KirillKobyakov/RP2350_Console/README.md

# RP2350_Console
A custom RP2350b console, which will include an LCD screen and rotary quad encoders. In this repository will include both hardware and software components for the design as well as assembly components and a tutorial.
