KirillKobyakov/RP2350_Console/Hardware/RP2350b_Console/RP2350_QFN80.step

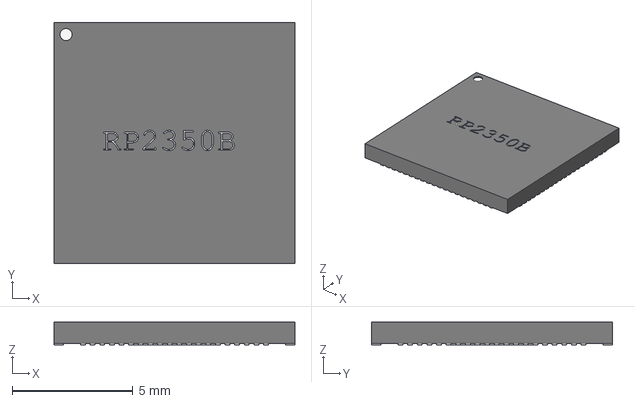
[picture p1: CAD file, 2025-08-28, an earlier design]
Hardware/RP2350b_Console/RP2350_QFN80.step
10.0 x 10.0 x 0.95 mm
