KirillKobyakov/RP2350_Console/Software/make.txt

arm-none-eabi-gcc -ffreestanding -march=armv8-m.main+fp+dsp -mfloat-abi=hard -mthumb -std=c11 -pedantic -Os  -Idrivers -Ibaremetal/include -Ilib -Iinclude -fdata-sections -ffunction-sections -Xlinker -gc-sections -Wall -c drivers/oled_spi.c -o oled_spi.o
arm-none-eabi-gcc -ffreestanding -march=armv8-m.main+fp+dsp -mfloat-abi=hard -mthumb -std=c11 -pedantic -Os  -Idrivers -Ibaremetal/include -Ilib -Iinclude -fdata-sections -ffunction-sections -Xlinker -gc-sections -Wall -c drivers/systick.c -o systick.o
arm-none-eabi-gcc -ffreestanding -march=armv8-m.main+fp+dsp -mfloat-abi=hard -mthumb -std=c11 -pedantic -Os  -Idrivers -Ibaremetal/include -Ilib -Iinclude -fdata-sections -ffunction-sections -Xlinker -gc-sections -Wall -c drivers/led.c -o led.o
arm-none-eabi-gcc -ffreestanding -march=armv8-m.main+fp+dsp -mfloat-abi=hard -mthumb -std=c11 -pedantic -Os  -Idrivers -Ibaremetal/include -Ilib -Iinclude -fdata-sections -ffunction-sections -Xlinker -gc-sections -Wall -c drivers/encoder.c -o encoder.o
arm-none-eabi-gcc -ffreestanding -march=armv8-m.main+fp+dsp -mfloat-abi=hard -mthumb -std=c11 -pedantic -Os  -Idrivers -Ibaremetal/include -Ilib -Iinclude -fdata-sections -ffunction-sections -Xlinker -gc-sections -Wall -c drivers/gpio_irq.c -o gpio_irq.o
arm-none-eabi-gcc -ffreestanding -march=armv8-m.main+fp+dsp -mfloat-abi=hard -mthumb -std=c11 -pedantic -Os  -Idrivers -Ibaremetal/include -Ilib -Iinclude -fdata-sections -ffunction-sections -Xlinker -gc-sections -Wall -c baremetal/_crt0.c -o _crt0.o
arm-none-eabi-gcc -ffreestanding -march=armv8-m.main+fp+dsp -mfloat-abi=hard -mthumb -std=c11 -pedantic -Os  -Idrivers -Ibaremetal/include -Ilib -Iinclude -fdata-sections -ffunction-sections -Xlinker -gc-sections -Wall -c baremetal/_flash_init.c -o _flash_init.o
arm-none-eabi-gcc -ffreestanding -march=armv8-m.main+fp+dsp -mfloat-abi=hard -mthumb -std=c11 -pedantic -Os  -Idrivers -Ibaremetal/include -Ilib -Iinclude -fdata-sections -ffunction-sections -Xlinker -gc-sections -Wall -c baremetal/_newlib_stubs.c -o _newlib_stubs.o
arm-none-eabi-gcc -ffreestanding -march=armv8-m.main+fp+dsp -mfloat-abi=hard -mthumb -std=c11 -pedantic -Os  -Idrivers -Ibaremetal/include -Ilib -Iinclude -fdata-sections -ffunction-sections -Xlinker -gc-sections -Wall -nostartfiles -specs=nano.specs -T baremetal/_flash.ld  -o dig_etch_a_sketch.elf src/dig_etch_a_sketch.c oled_spi.o systick.o led.o encoder.o gpio_irq.o _crt0.o _flash_init.o _newlib_stubs.o

Generated Program has the following segments: n

section  size  addr
.boot    296   0x10000000
TEXT     1908  0x10000128
DATA     2     0x20000000
BSS      1105  0x20000008
tools/elf2uf2.py -v dig_etch_a_sketch.elf
dig_etch_a_sketch.elf is valid 32b ARM little-endian ELF file
ELF contains loadable flash segment at 0x10000000
ELF contains loadable flash segment at 0x1000089c
Skipping program header for non-loadable segment
Flash only binary; UF2 will program flash.
Processing 2206 byte segment at physical address 10000000
Writing output to dig_etch_a_sketch.uf2
Writing UF2 record of 256B @ addr 0x10000000
Writing UF2 record of 256B @ addr 0x10000100
Writing UF2 record of 256B @ addr 0x10000200
Writing UF2 record of 256B @ addr 0x10000300
Writing UF2 record of 256B @ addr 0x10000400
Writing UF2 record of 256B @ addr 0x10000500
Writing UF2 record of 256B @ addr 0x10000600
Writing UF2 record of 256B @ addr 0x10000700
Writing UF2 record of 256B @ addr 0x10000800
rm _crt0.o _newlib_stubs.o encoder.o _flash_init.o gpio_irq.o oled_spi.o dig_etch_a_sketch.elf led.o systick.o
