KirillKobyakov/RP2350_Console/Hardware/RP2350b_Console/BottomViewPCB.pdf

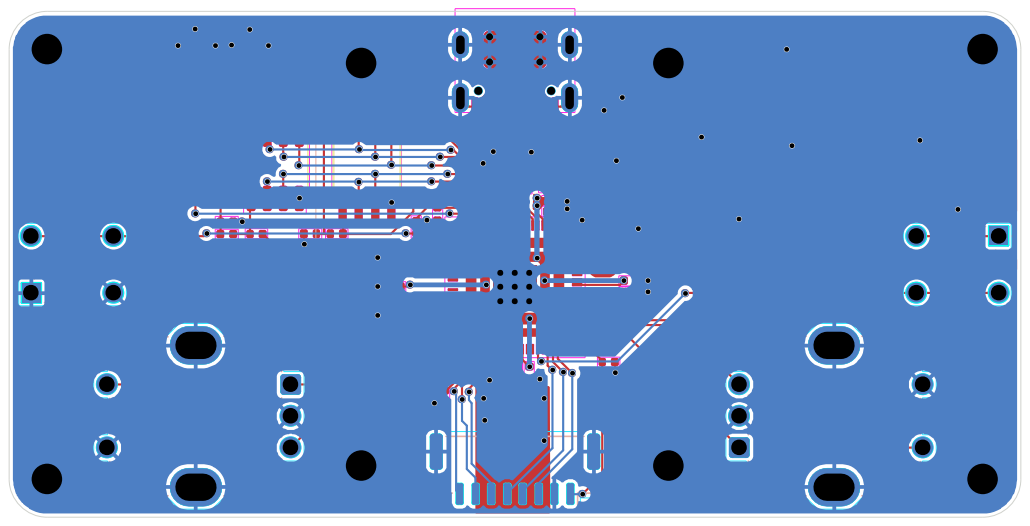
[picture p2: page 1]
