KirillKobyakov/RP2350_Console/Hardware/RP2350b_Console/Schematic.pdf

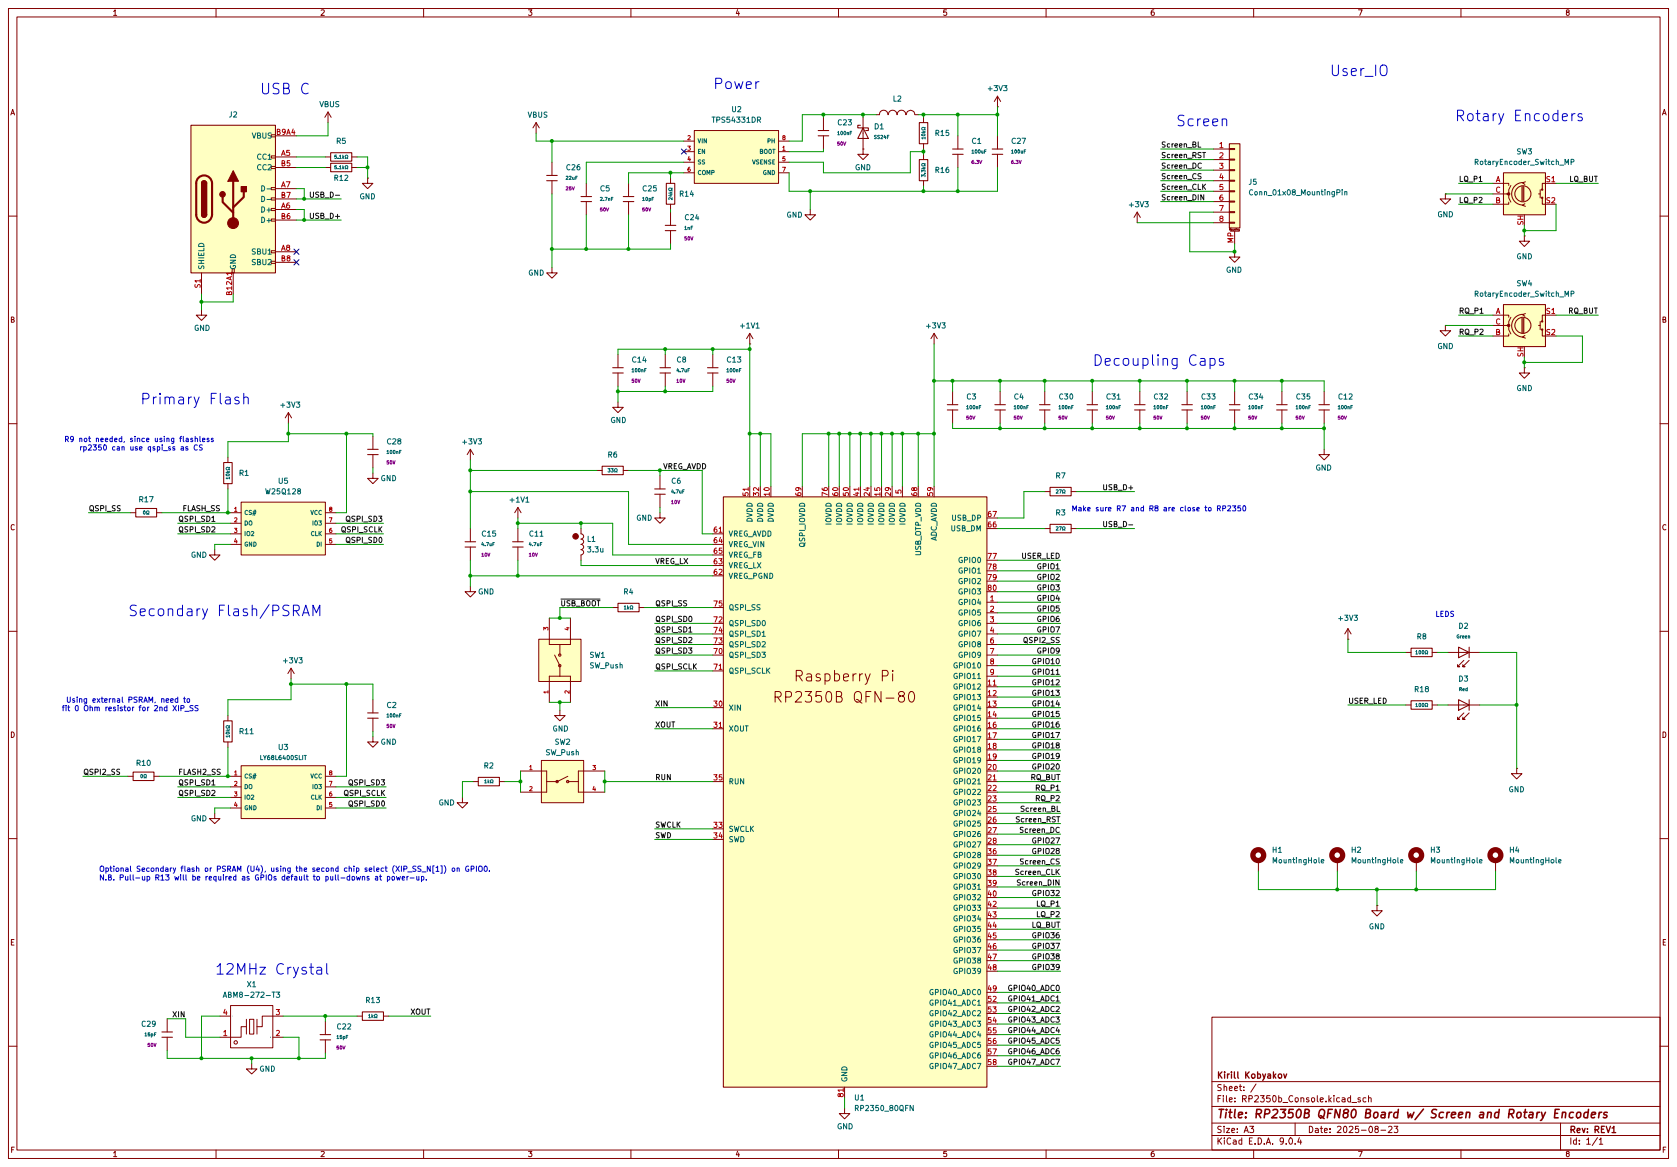
[picture p3: page 1]
