KirillKobyakov/RP2350_Console/Hardware/RP2350b_Console/TopPCBView.pdf

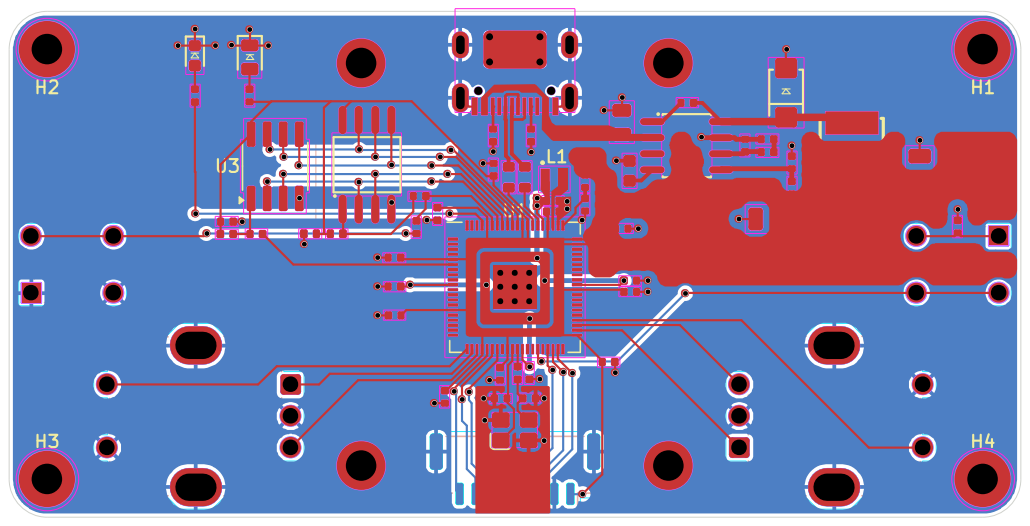
[picture p4: page 1]
