KirillKobyakov/RP2350_Console/HardwareV2/RP2350b_Console_v2.kicad_pcb

## KiCad design HardwareV2/RP2350b_Console_v2.kicad_pcb (2026-04-26)

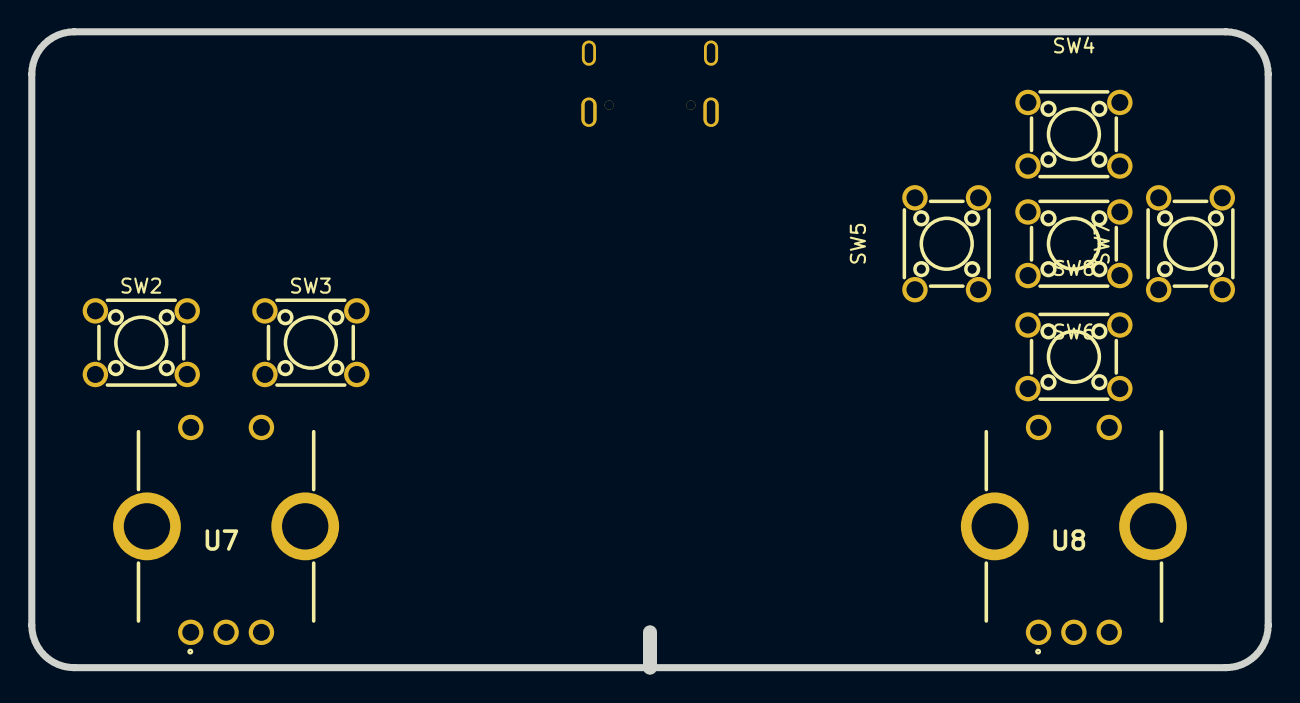
[picture p5: board RP2350b_Console_v2.kicad_pcb from above]

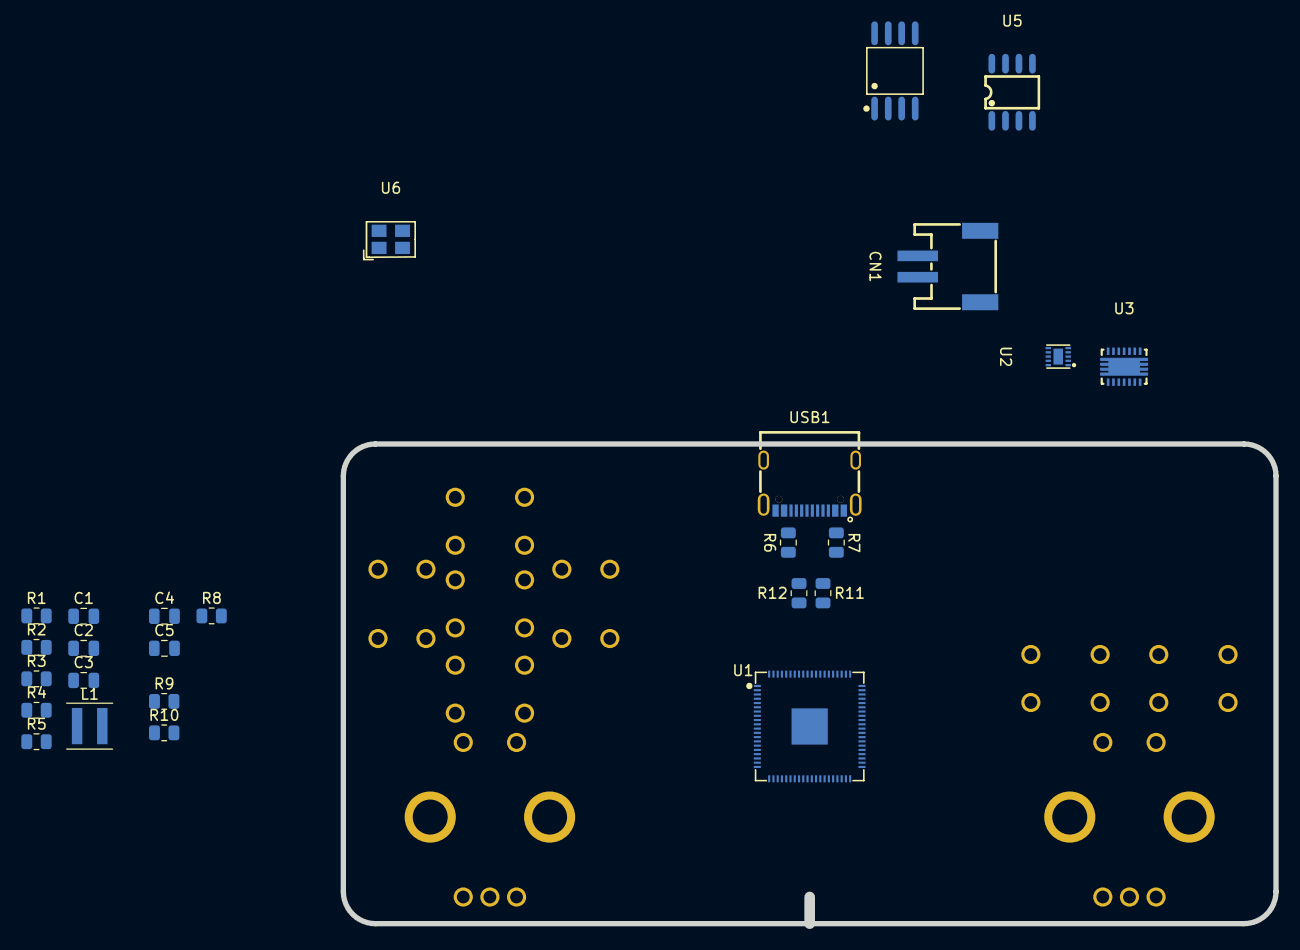
[picture p6: board RP2350b_Console_v2.kicad_pcb from below]

Board: 4 copper layers, 87.5 x 45.0 mm, 35 parts (26 on the bottom side), 26 nets, no tracks yet.

Parts:
C1: 47u; C_0805_2012Metric
C2: 22u; C_0805_2012Metric
C3: 100n; C_0805_2012Metric
C4, C5: 15p; C_0805_2012Metric
CN1: S2B-PH-SM4-TB(LF)(SN); CONN-SMD_P2.00_S2B-PH-SM4-TB-LF-SN
L1: 1.5u; L_Coilcraft_XxL4020
R1: 2k; R_0805_2012Metric
R2: 540; R_0805_2012Metric
R3: 10k; R_0805_2012Metric
R4, R5: R; R_0805_2012Metric
R6, R7: 5.1k; R_0805_2012Metric
R8, R9, R10: 1k; R_0805_2012Metric
R11, R12: 27; R_0805_2012Metric
SW2, SW3, SW4, SW5, SW6, SW7, SW8: 1825910-6; SW-TH_4P-L6.0-W6.0-P4.50-LS6.5
U1: RP2350B_C42415655; QFN-80_L10.0-W10.0-P0.40-TL-EP3.4
U2: BQ24040DSQR; WSON-10_L2.0-W2.0-P0.40-BL-EP
U3: TPS63021DSJR; VSON-14_L4.0-W3.0-P0.50-BL-EP_TI_DSJ
U4: W25Q128JVSIQTR; SOIC-8_L5.3-W5.3-P1.27-LS8.0-BL
U5: LY68L6400SLIT; SOP-8_L4.9-W3.9-P1.27-LS6.0-BL
U6: ABM8-272-T3; CRYSTAL-SMD_4P-L3.2-W2.5-BL-2
U7, U8: PEC12R-4215F-S0024; PEC12R-4XXXF-SXXXX_1
USB1: USB-310; USB-C-SMD_20P-P0.50-L7.4-W8.9

Connections:
+3V3: C1.1, U3.3 (FB), U3.4 (VOUT), U3.5 (VOUT), U4.8 (VCC), U5.8 (VCC)
+BATT: C2.1, CN1.1, R4.2, R5.2, U2.10 (OUT), U3.10 (VIN), U3.11 (VIN)
GND: C1.2, C2.2, C3.2, C4.2, C5.2, CN1.2, CN1.3, CN1.4, R1.2, R2.2, R3.2, R6.2, R7.2, SW2.3, SW2.4, SW3.3, SW3.4, U2.3 (VSS), U2.7 (ISET2), U2.11 (EP), U3.2 (GND), U3.13 (PS/SYNC), U3.15 (PGND), U4.4 (GND), U5.4 (VSS), U6.2 (GND), U6.4 (GND), USB1.0, USB1.A1 (GND), USB1.A12 (GND), USB1.B1 (GND), USB1.B12 (GND)
unnamed: C4.1, R8.1, U6.3
unnamed: L1.1, U3.8 (L1), U3.9 (L1)
unnamed: L1.2, U3.6 (L2), U3.7 (L2)
unnamed: R9.2, SW2.1, SW2.2
unnamed: R10.2, SW3.1, SW3.2
unnamed: C3.1, U3.1 (VINA)
unnamed: R11.2, U1.66 (USB_DM)
unnamed: R12.2, U1.67 (USB_DP)
unnamed: R2.1, U2.2 (ISET)
unnamed: R1.1, U2.4 (PRETERM)
unnamed: R3.1, U2.9 (TS)
unnamed: R6.1, USB1.A5 (CC1)
unnamed: R7.1, USB1.B5 (CC2)
QSPI_0: U1.72 (QSPI_SD0), U4.5 (DI), U5.5 (SI/SIO[0])
QSPI_1: U1.74 (QSPI_SD1), U4.2 (DO), U5.2 (SO/SIO[1])
QSPI_2: U1.73 (QSPI_SD2), U4.3 (IO2), U5.3 (SIO[2])
QSPI_3: U1.70 (QSPI_SD3), U4.7 (IO3), U5.7 (SIO[3])
QSPI_CLK: U1.71 (QSPI_SCLK), U4.6 (CLK), U5.6 (SCLK)
QSPI_SS0: R9.1, U1.75 (QSPI_SS), U4.1 (~CS)
USB_D+: R12.1, USB1.A6 (D+), USB1.B6 (D+)
USB_D-: R11.1, USB1.A7 (D-), USB1.B7 (D-)
VBUS: U2.1 (IN), USB1.A4 (VBUS), USB1.A9 (VBUS), USB1.B4 (VBUS), USB1.B9 (VBUS)
XIN: C5.1, U6.1
