KirillKobyakov/RP2350_Console/Hardware/RP2350b_Console/RP2350b_Console.kicad_pcb

## KiCad design Hardware/RP2350b_Console/RP2350b_Console.kicad_pcb (2025-11-08, an earlier design)

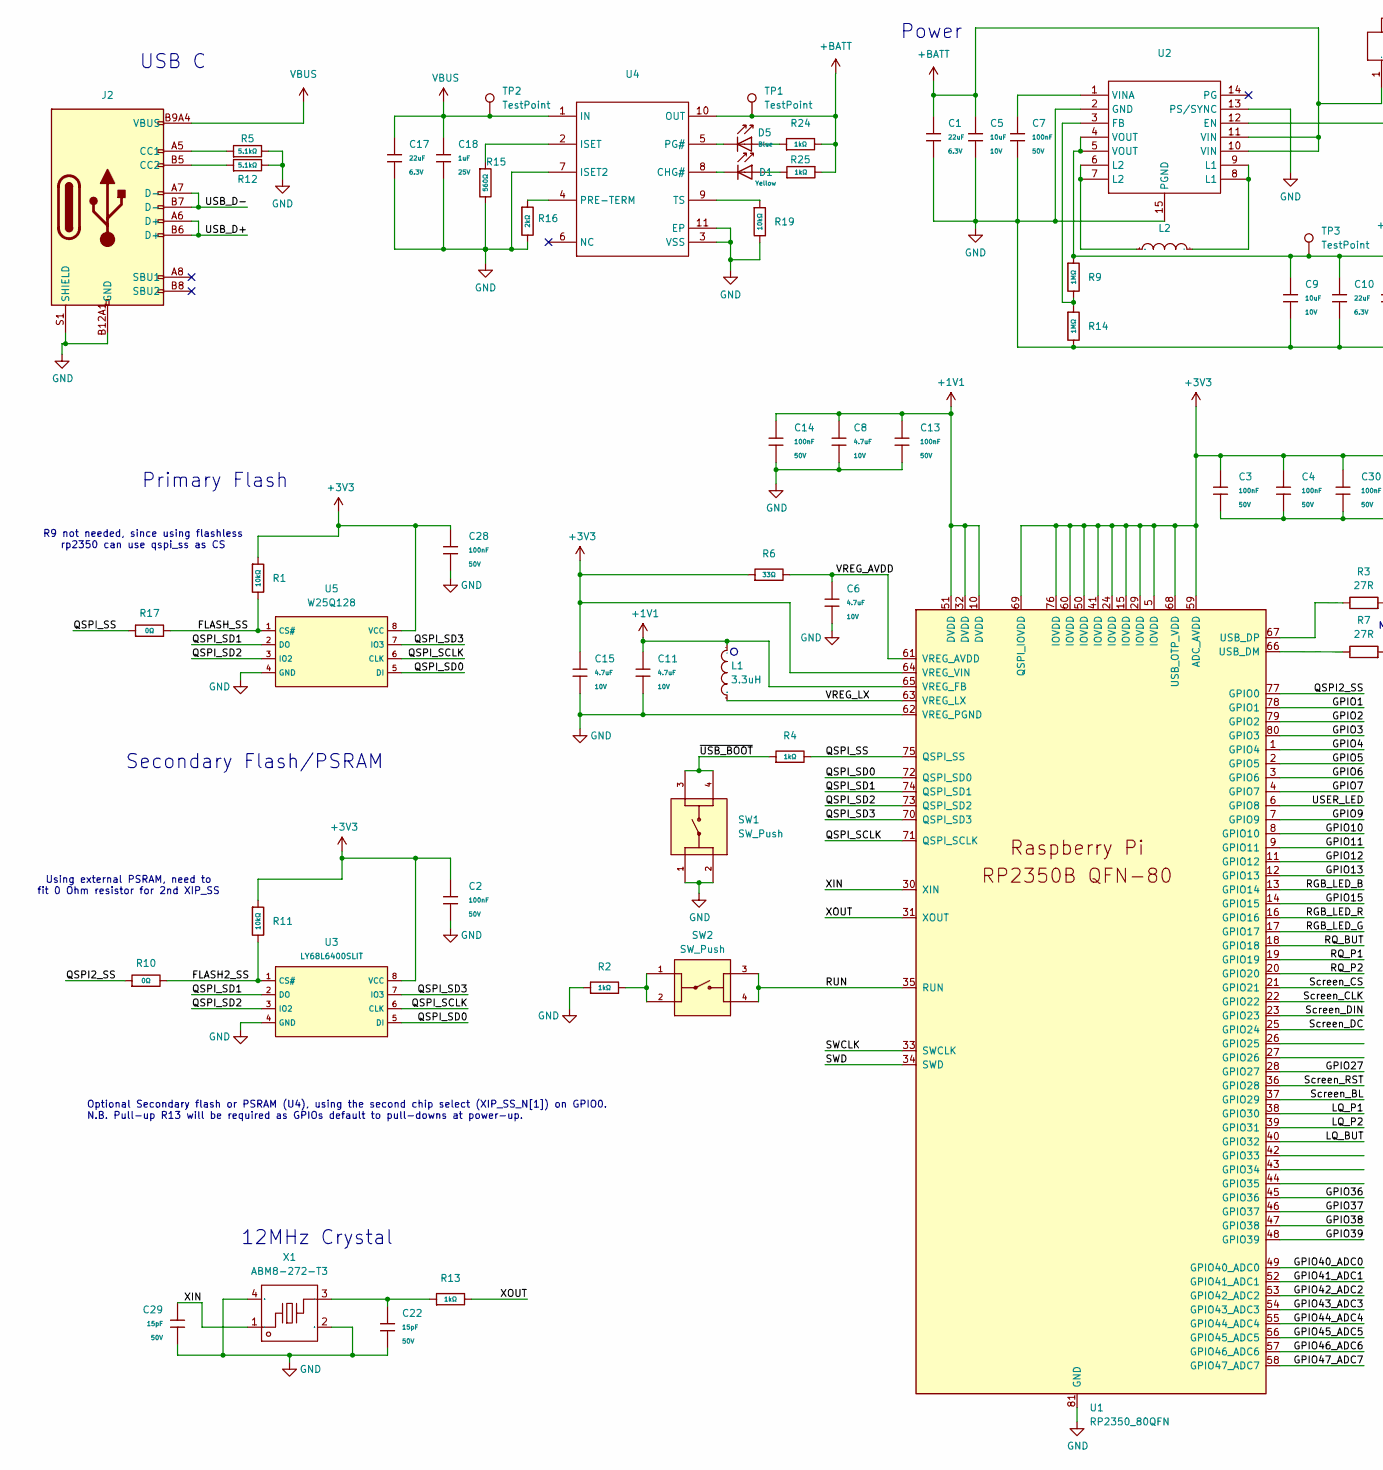
[picture p7: schematic RP2350b_Console.kicad_sch, RP2350b Console, part in row 1, column 1]

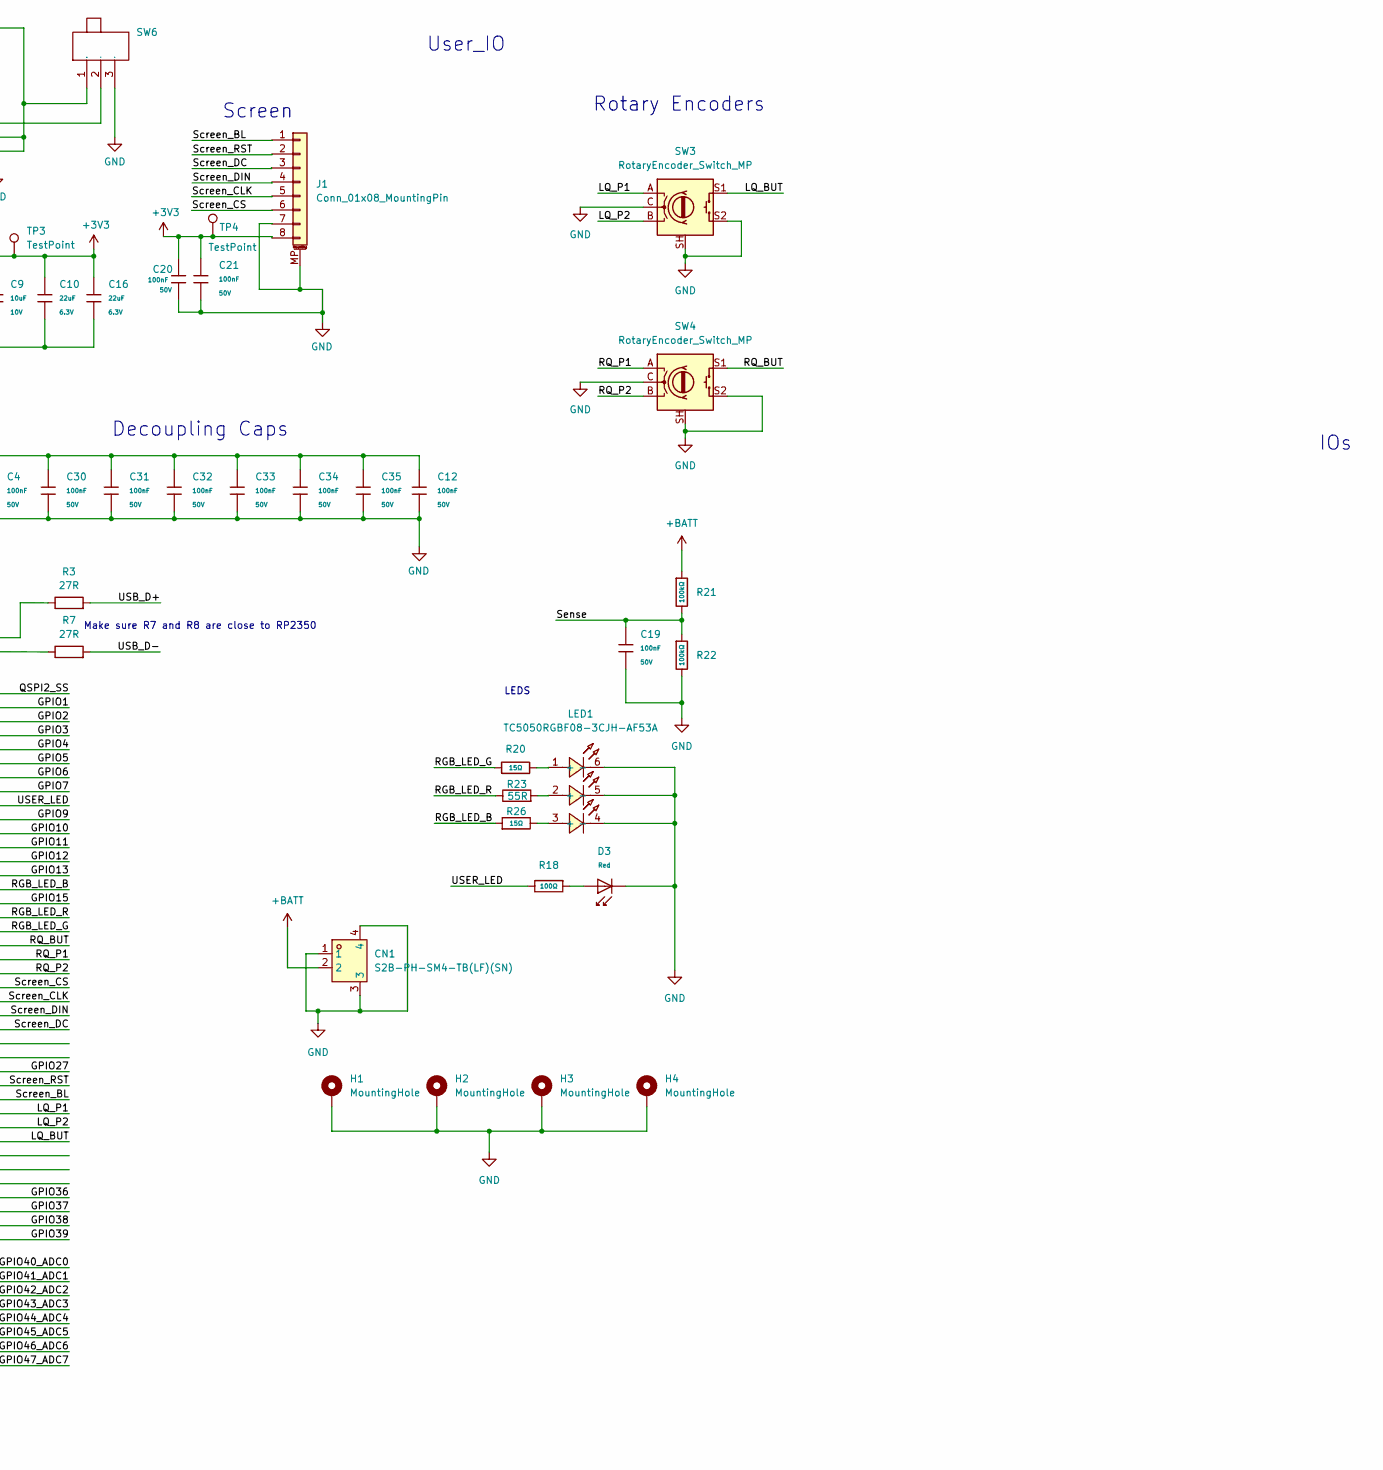
[picture p8: schematic RP2350b_Console.kicad_sch, RP2350b Console, part in row 1, column 2]

Parts:
C1, C10, C16, C17: 22uF; C_0603; Voltage Rated 6.3V; Tolerance ±20%; Part CL10A226MQ8NRNC; LCSC C59461
C2, C3, C4, C7, C12, C13, C14, C19, C20, C21, C28, C30, C31, C32, C33, C34, C35: 100nF; C_0402; Voltage Rated 50V; Tolerance ±10%; Part CL05B104KB54PNC; LCSC C307331
C5, C9: 10uF; C_0603; Voltage Rated 10V; Tolerance ±10%; Part CL10A106KP8NNNC; LCSC C19702
C6, C8, C11, C15: 4.7uF; C_0402; Voltage Rated 10V; Tolerance ±20%; Part CL05A475MP5NRNC; LCSC C23733
C18: 1uF; C_0402; Voltage Rated 25V; Tolerance ±10%; Part CL05A105KA5NQNC; LCSC C52923
C22, C29: 15pF; C_0402; Voltage Rated 50V; Tolerance ±5%; Part 0402CG150J500NT; LCSC C1548
CN1: S2B-PH-SM4-TB(LF)(SN); CONN-SMD_P2.00_S2B-PH-SM4-TB-LF-SN; LCSC Part C295747
D1: Yellow; LED0603-R-RD_AMBER; Part KT-0603R; LCSC C2286
D3: Red; D_0603; Part KT-0603R; LCSC C2286
D5: Blue; LED0603-FD_BLUE; Part KT-0603R; LCSC C2286
H1, H2, H3, H4: MountingHole; MountingHole_2.2mm_M2_Pad_TopBottom
J1: Conn_01x08_MountingPin; Seeed 1.69 Inch LCD Module
J2: Connector, USB-TYPE-C-16P; TYPE-C-SMD_HX-TYPE-C-16PIN; LCSC C2927039
L1: 3.3uH; IND-SMD_L2.0-W1.6_AOTA-B201610S3R3-101-T; Manufacturer Part AOTA-B201610S3R3-101-T; LCSC Part Name AOTA-B201610S3R3-101-T
L2: 1.5uH; IND-SMD_L4.0-W4.0-A; Manufacturer Part XFL4020-152MEC; LCSC Part Name 1.5uH ±20%
LED1: TC5050RGBF08-3CJH-AF53A; LED-SMD_6P-L5.0-W5.0-TL_TC5050RGBF08; LCSC Part C784540
R1, R11, R19: 10kΩ; R_0402; Overload Voltage (Max) 50V; Tolerance ±1%; Part 0402WGF1002TCE; LCSC C25744
R2, R4, R13, R24, R25: 1kΩ; R_0402; Overload Voltage (Max) 50V; Tolerance ±1%; Part 0402WGF1001TCE; LCSC C11702
R3, R7: 27R; R0201
R5, R12: 5.1kΩ; R_0402; Overload Voltage (Max) 50V; Tolerance ±1%; Part 0402WGF5101TCE; LCSC C25905
R6: 33Ω; R_0402; Overload Voltage (Max) 50V; Tolerance ±1%; Part 0402WGF330JTCE; LCSC C25105
R9, R14: 1MΩ; R_0603; Overload Voltage (Max) 75V; Tolerance ±1%; Part 0603WAF1004T5E; LCSC C22935
R10, R17: 0Ω; R_0402; Overload Voltage (Max) 50V; Tolerance ±1%; Part 0402WGF0000TCE; LCSC C17168
R15: 560Ω; R_0603; Overload Voltage (Max) 75V; Tolerance ±1%; Part 0603WAF5600T5E; LCSC C23204
R16: 2kΩ; R_0402; Overload Voltage (Max) 50V; Tolerance ±1%; Part 0402WGF2001TCE; LCSC C4109
R18: 100Ω; R_0402; Overload Voltage (Max) 50V; Tolerance ±1%; Part 0402WGF1000TCE; LCSC C25076
R20, R26: 15Ω; R_0603; Overload Voltage (Max) 75V; Tolerance ±1%; Part 0603WAF150JT5E; LCSC C22810
R21, R22: 100kΩ; R_0603; Overload Voltage (Max) 75V; Tolerance ±1%; Part 0603WAF1003T5E; LCSC C25803
R23: 55R; R_0603
SW1, SW2: SW_Push; SW-TH_4P-L6.0-W6.0-P4.50-LS6.5; PARTREV C10
SW3, SW4: RotaryEncoder_Switch_MP; RotaryEncoder_Bourns_Vertical_PEC12R-3x17F-Sxxxx
SW6: SW-TH_MK-12D18-G040; Manufacturer Part MK-12D18-G040; LCSC Part Name 微型拨动开关
TP1, TP2, TP3, TP4: TestPoint; TestPoint_Pad_1.0x1.0mm
U1: RP2350_80QFN; RP2350-QFN-80-1EP_10x10_P0.4mm_EP3.4x3.4mm_ThermalVias
U2: VSON-14_L4.0-W3.0-P0.50-BL-EP_TI_DSJ; Manufacturer Part TPS63020DSJR; LCSC Part Name 高效率单电感升降压转换器
U3: LY68L6400SLIT; SOP-8_3.76x4.96mm_P1.27mm; LCSC C261881
U4: MSOP-10_L3.0-W3.0-P0.50-LS5.0-BL-EP; Manufacturer Part BQ24092DGQR; LCSC Part Name bq2409x 1A，单输入，单节锂离子和锂聚合物电池充电器
U5: W25Q128; SOIC-8_L5.3-W5.3-P1.27-LS8.0-BL; Part W25Q128JVSIQ; LCSC C97521
X1: ABM8-272-T3; CRYSTAL-SMD_4P-L3.2-W2.5-BL; Manufacturer Part ABM8-272-T3; LCSC Part Name ABM8-272-T3

Connections:
+1V1: C8.1, C11.1, C13.1, C14.1, L1.2, U1.10 (DVDD), U1.32 (DVDD), U1.51 (DVDD), U1.65 (VREG_FB)
+3V3: C2.1, C3.1, C4.1, C9.1, C10.1, C12.1, C15.1, C16.1, C20.1, C21.1, C28.1, C30.1, C31.1, C32.1, C33.1, C34.1, C35.1, J1.8, R1.1, R6.1, R9.1, R11.1, TP3.1, TP4.1, U1.5 (IOVDD), U1.15 (IOVDD), U1.24 (IOVDD), U1.29 (IOVDD), U1.41 (IOVDD), U1.50 (IOVDD), U1.59 (ADC_AVDD), U1.60 (IOVDD), U1.64 (VREG_VIN), U1.68 (USB_OTP_VDD), U1.69 (QSPI_IOVDD), U1.76 (IOVDD), U2.4 (VOUT), U2.5 (VOUT), U3.8 (VCC), U5.8 (VCC)
+BATT: C1.1, C5.1, CN1.2, R21.1, R24.2, R25.2, SW6.1, TP1.1, U2.10 (VIN), U2.11 (VIN), U4.10 (OUT)
/FLASH2_SS: R10.2, R11.2, U3.1 (CS#)
/FLASH_SS: R1.2, R17.2, U5.1 (CS#)
/GPIO1: U1.78 (GPIO1)
/GPIO2: U1.79 (GPIO2)
/GPIO3: U1.80 (GPIO3)
/GPIO4: U1.1 (GPIO4)
/GPIO5: U1.2 (GPIO5)
/GPIO6: U1.3 (GPIO6)
/GPIO7: U1.4 (GPIO7)
/GPIO9: U1.7 (GPIO9)
/GPIO10: U1.8 (GPIO10)
/GPIO11: U1.9 (GPIO11)
/GPIO12: U1.11 (GPIO12)
/GPIO13: U1.12 (GPIO13)
/GPIO15: U1.14 (GPIO15)
/GPIO27: U1.28 (GPIO27)
/GPIO36: U1.45 (GPIO36)
/GPIO37: U1.46 (GPIO37)
/GPIO38: U1.47 (GPIO38)
/GPIO39: U1.48 (GPIO39)
/GPIO40_ADC0: U1.49 (GPIO40_ADC0)
/GPIO41_ADC1: U1.52 (GPIO41_ADC1)
/GPIO42_ADC2: U1.53 (GPIO42_ADC2)
/GPIO43_ADC3: U1.54 (GPIO43_ADC3)
/GPIO44_ADC4: U1.55 (GPIO44_ADC4)
/GPIO45_ADC5: U1.56 (GPIO45_ADC5)
/GPIO46_ADC6: U1.57 (GPIO46_ADC6)
/GPIO47_ADC7: U1.58 (GPIO47_ADC7)
/LQ_BUT: SW3.S1, U1.40 (GPIO32)
/LQ_P1: SW3.A, U1.38 (GPIO30)
/LQ_P2: SW3.B, U1.39 (GPIO31)
/QSPI2_SS: R10.1, U1.77 (GPIO0)
/QSPI_SCLK: U1.71 (QSPI_SCLK), U3.6 (CLK), U5.6 (CLK)
/QSPI_SD0: U1.72 (QSPI_SD0), U3.5 (DI), U5.5 (DI)
/QSPI_SD1: U1.74 (QSPI_SD1), U3.2 (DO), U5.2 (DO)
/QSPI_SD2: U1.73 (QSPI_SD2), U3.3 (IO2), U5.3 (IO2)
/QSPI_SD3: U1.70 (QSPI_SD3), U3.7 (IO3), U5.7 (IO3)
/QSPI_SS: R4.2, R17.1, U1.75 (QSPI_SS)
/RGB_LED_B: R26.1, U1.13 (GPIO14)
/RGB_LED_G: R20.1, U1.17 (GPIO17)
/RGB_LED_R: R23.1, U1.16 (GPIO16)
/RQ_BUT: SW4.S1, U1.18 (GPIO18)
/RQ_P1: SW4.A, U1.19 (GPIO19)
/RQ_P2: SW4.B, U1.20 (GPIO20)
/RUN: SW2.3, SW2.4, U1.35 (RUN)
/SWCLK: U1.33 (SWCLK)
/SWD: U1.34 (SWD)
/Screen_BL: J1.1, U1.37 (GPIO29)
/Screen_CLK: J1.5, U1.22 (GPIO22)
/Screen_CS: J1.6, U1.21 (GPIO21)
/Screen_DC: J1.3, U1.25 (GPIO24)
/Screen_DIN: J1.4, U1.23 (GPIO23)
/Screen_RST: J1.2, U1.36 (GPIO28)
/Sense: C19.1, R21.2, R22.1
/USB_D+: J2.A6 (D+), J2.B6 (D+), R3.2
/USB_D-: J2.A7 (D-), J2.B7 (D-), R7.2
/USER_LED: R18.2, U1.6 (GPIO8)
/VREG_AVDD: C6.1, R6.2, U1.61 (VREG_AVDD)
/VREG_LX: L1.1, U1.63 (VREG_LX)
/XIN: C29.1, U1.30 (XIN), X1.1
/XOUT: R13.2, U1.31 (XOUT)
/~USB_BOOT: R4.1, SW1.3, SW1.4
GND: C1.2, C2.2, C3.2, C4.2, C5.2, C6.2, C7.2, C8.2, C9.2, C10.2, C11.2, C12.2, C13.2, C14.2, C15.2, C16.2, C17.2, C18.2, C19.2, C20.2, C21.2, C22.2, C28.2, C29.2, C30.2, C31.2, C32.2, C33.2, C34.2, C35.2, CN1.1, CN1.3, CN1.4, D3.1, H1.1, H2.1, H3.1, H4.1, J1.7, J1.MP (MountPin), J2.A12B1 (GND), J2.B12A1 (GND), J2.S1 (SHIELD), LED1.4 (-), LED1.5 (-), LED1.6 (-), R2.1, R5.2, R12.2, R14.2, R15.2, R16.2, R19.2, R22.2, SW1.1, SW1.2, SW3.C, SW3.S2, SW3.SH, SW4.C, SW4.S2, SW4.SH, SW6.3, U1.62 (VREG_PGND), U1.81 (GND), U2.2 (GND), U2.13 (PS/SYNC), U2.15 (PGND), U3.4 (GND), U4.3 (VSS), U4.7 (ISET2), U4.11 (EP), U5.4 (GND), X1.2 (GND), X1.4 (GND)
unnamed: C22.1, R13.1, X1.3
unnamed: D1.2, R25.1
unnamed: D3.2, R18.1
unnamed: D5.2, R24.1
unnamed: J2.A5 (CC1), R5.1
unnamed: J2.B5 (CC2), R12.1
unnamed: L2.1, U2.6 (L2), U2.7 (L2)
unnamed: L2.2, U2.8 (L1), U2.9 (L1)
unnamed: LED1.1 (+), R20.2
unnamed: LED1.2 (+), R23.2
unnamed: LED1.3 (+), R26.2
unnamed: R2.2, SW2.1, SW2.2
unnamed: R7.1, U1.66 (USB_DM)
unnamed: R3.1, U1.67 (USB_DP)
unnamed: SW6.2, U2.12 (EN)
unnamed: R9.2, R14.1, U2.3 (FB)
unnamed: C7.1, U2.1 (VINA)
unnamed: D1.1, U4.8 (CHG#)
unnamed: R15.1, U4.2 (ISET)
unnamed: D5.1, U4.5 (PG#)
unnamed: R16.1, U4.4 (PRE-TERM)
unnamed: R19.1, U4.9 (TS)
VBUS: C17.1, C18.1, J2.A9B4 (VBUS), J2.B9A4 (VBUS), TP2.1, U4.1 (IN)

Notes on the sheet:
Optional Secondary flash or PSRAM (U4), using the second chip select (XIP_SS_N[1]) on GPIO0. N.B. Pull-up R13 will be required as GPIOs default to pull-downs at power-up.
USB C
Decoupling Caps
IOs
Rotary Encoders
R9 not needed, since using flashless rp2350 can use qspi_ss as CS
12MHz Crystal
Primary Flash
LEDS
Make sure R7 and R8 are close to RP2350
Secondary Flash/PSRAM
Screen
User_IO
Power
Using external PSRAM, need to fit 0 Ohm resistor for 2nd XIP_SS

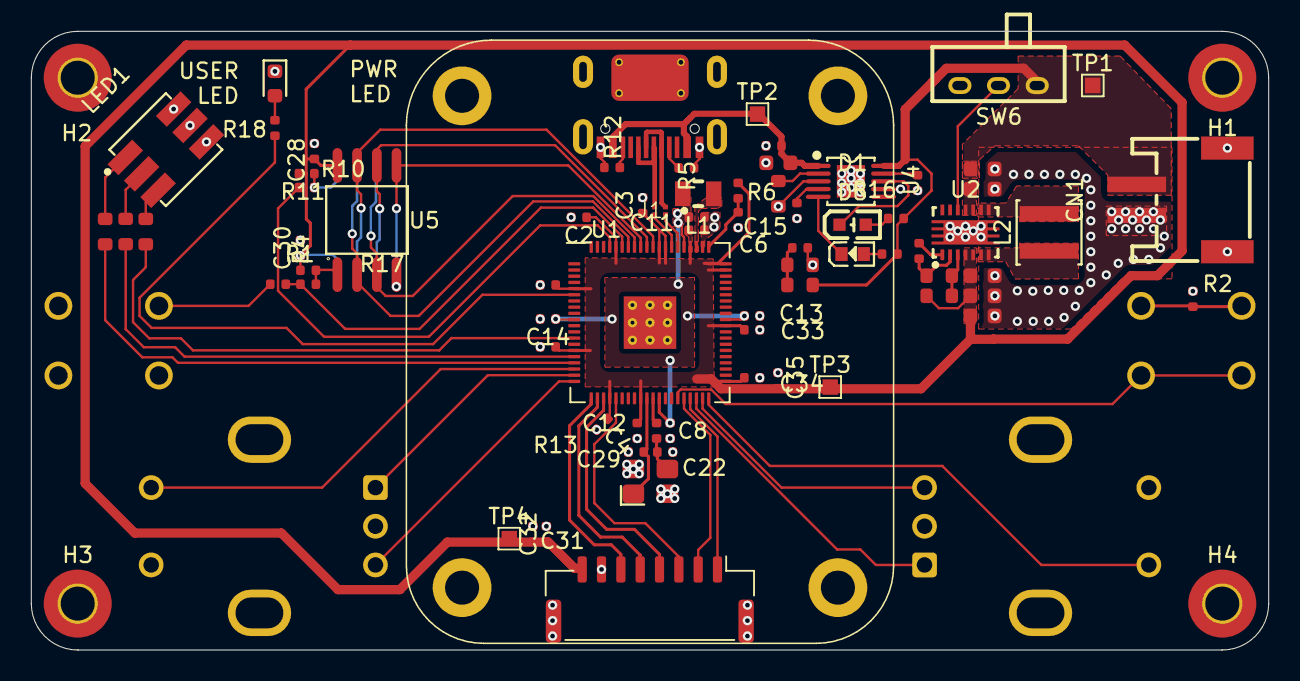
[picture p9: board RP2350b_Console.kicad_pcb from above]

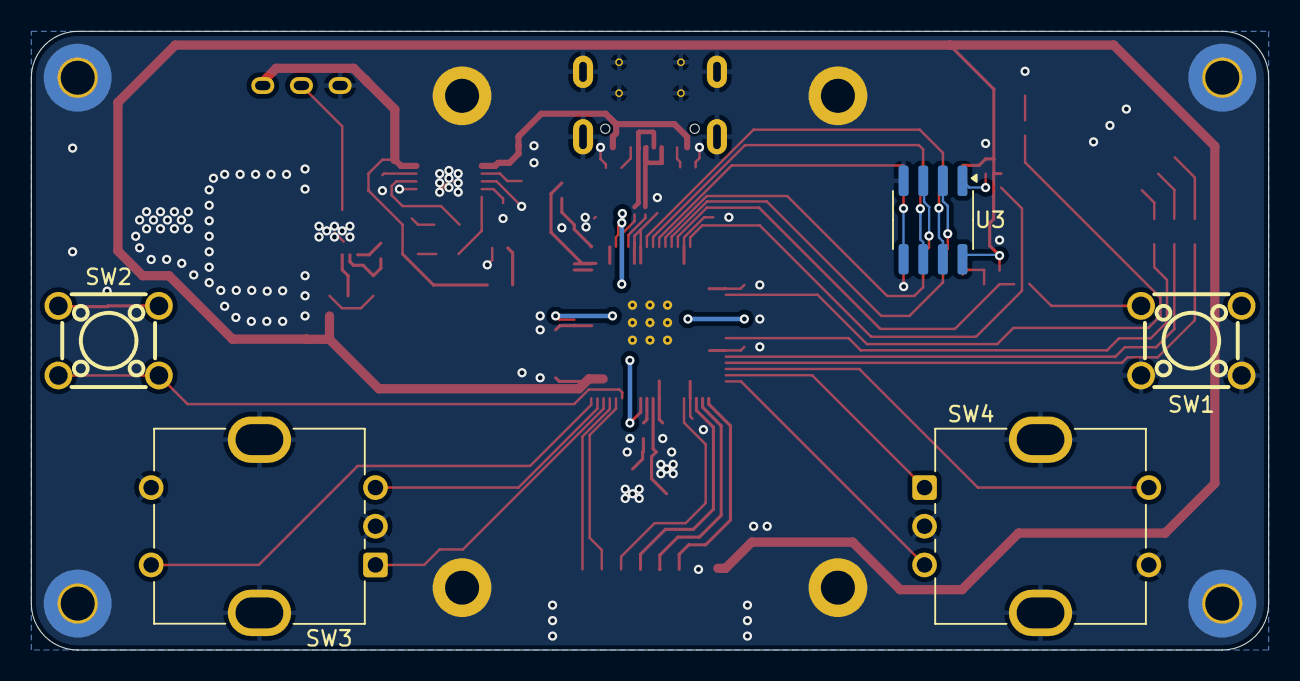
[picture p10: board RP2350b_Console.kicad_pcb from below]

Board: 2 copper layers, 80.0 x 40.0 mm, 83 parts (5 on the bottom side), 61 nets.
