KirillKobyakov/RP2350_Console/(commit log)

2025-08-24 Initial KiCad project file
2025-08-28 first build
    first full build/hw design of the pcb. Changes to be made fr fr
    [RP2350_QFN80.step, RP2350b_Console.kicad_pcb, RP2350b_Console.kicad_sch, bom.csv, designators.csv, positions.csv, screen.kicad_sch]
2025-09-05 half way through second version
    [RP2350b_Console.kicad_pcb, RP2350b_Console.kicad_sch]
2025-09-24 updates to project
    [RP2350b_Console.kicad_pcb, bom.csv, designators.csv, positions.csv]
2025-10-17 updates - build 1
    [RP2350b_Console.kicad_pcb, RP2350b_Console.kicad_sch, bom.csv, positions.csv]
2025-10-18 Restructuring repository
    [RP2350_QFN80.step, RP2350b_Console.kicad_pcb, RP2350b_Console.kicad_sch, bom.csv, designators.csv, positions.csv, screen.kicad_sch]
2025-11-05 updates to pcb
    [RP2350b_Console.kicad_pcb]
2025-11-08 v2.0 design files
    [RP2350b_Console.kicad_pcb, RP2350b_Console.kicad_sch]
2025-12-26 hardware v2
    [RP2350b_Console_v2.kicad_pcb, RP2350b_Console_v2.kicad_sch]
2025-12-26 added updated battery and power schematic
    [RP2350b_Console_v2.kicad_sch, power.kicad_sch, usb.kicad_sch]
2025-12-31 commiting before flight :), added in crystal and started doing the labels for the RP2350b
    [RP2350b_Console_v2.kicad_sch, crystal.kicad_sch, memory.kicad_sch, power.kicad_sch, usb.kicad_sch]
2026-01-21 updates pre routing
    [RP2350b_Console_v2.kicad_sch, core.kicad_sch, usb.kicad_sch, user_io.kicad_sch]
2026-04-26 initial v2 pcb layout minus passives
    [RP2350b_Console_v2.kicad_pcb, RP2350b_Console_v2.kicad_sch, core.kicad_sch, crystal.kicad_sch, memory.kicad_sch, power.kicad_sch, usb.kicad_sch, user_io.kicad_sch]
